set-soft/RemoteControl/electronics/mainboard/mainboard.step

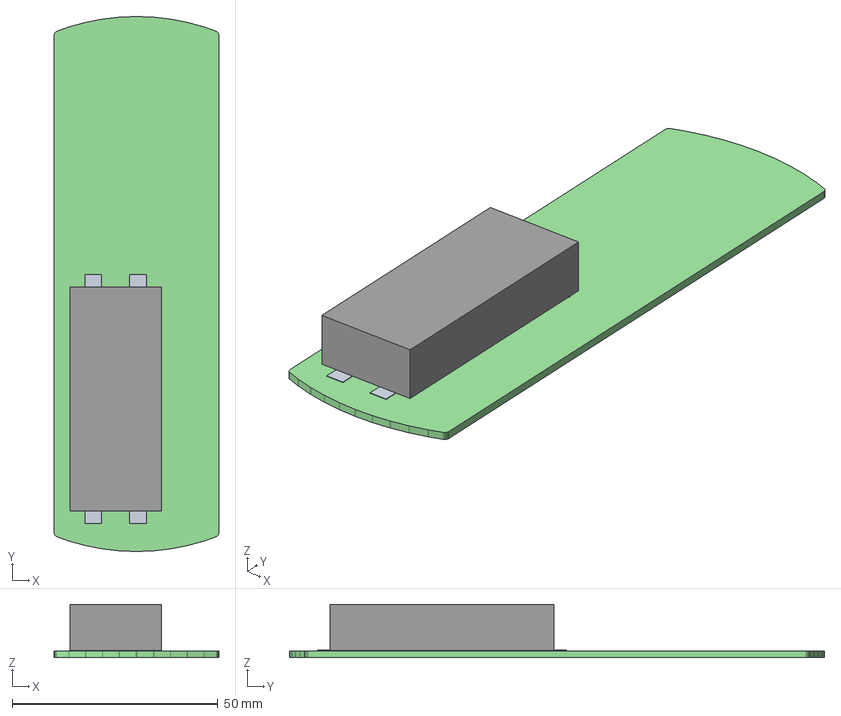
[picture p1: CAD file, 2022-05-20]
electronics/mainboard/mainboard.step
40.0 x 130.0 x 13.0 mm
mainboard PCB
