set-soft/RemoteControl/mechanics/mainboard.3mf

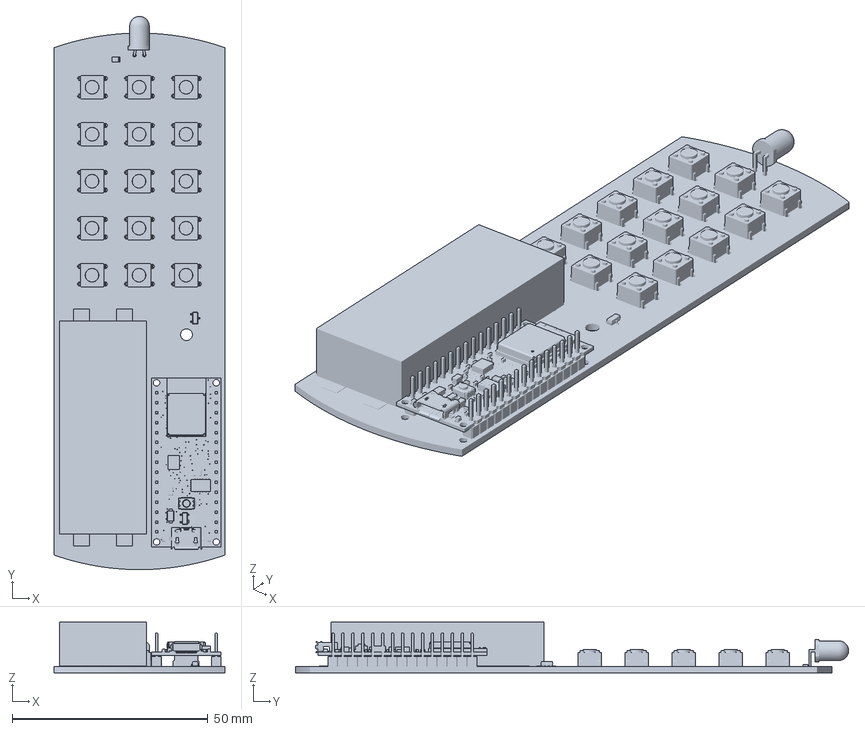
[picture p2: CAD file, 2022-06-04]
mechanics/mainboard.3mf
43.7 x 141.3 x 12.9 mm
