set-soft/RemoteControl/mechanics/mainboard_outline.dxf

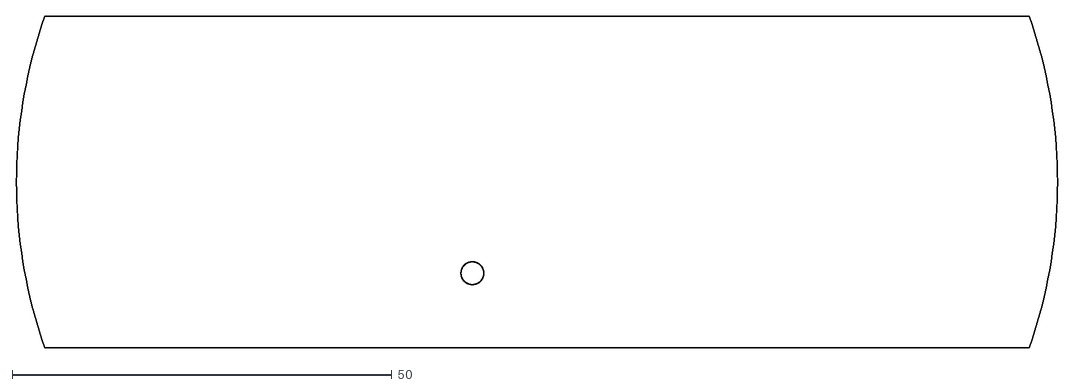
[picture p3: CAD file, 2022-06-04]
mechanics/mainboard_outline.dxf
137.0 x 43.7
