set-soft/RemoteControl/mechanics/printLayout.3mf

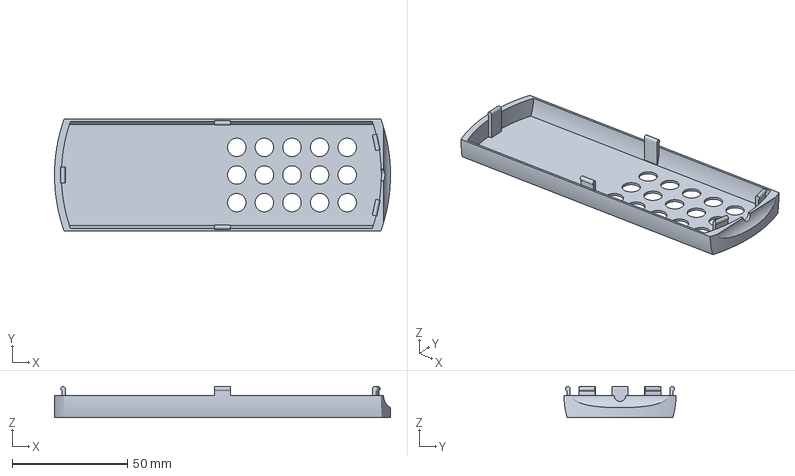
[picture p4: CAD file, 2022-06-06]
mechanics/printLayout.3mf
146.0 x 48.7 x 13.5 mm
