set-soft/RemoteControl/mechanics/buttons.3mf

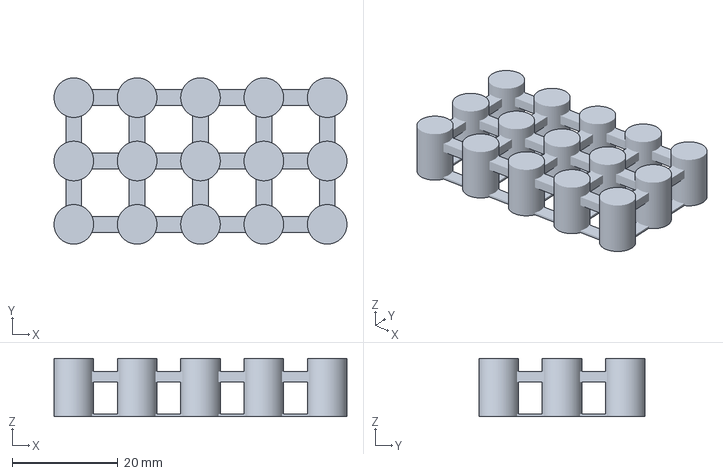
[picture p5: CAD file, 2022-06-06]
mechanics/buttons.3mf
55.5 x 31.5 x 11.0 mm
