set-soft/RemoteControl/mechanics/parameters.scad

case_wallThickness = 1;

case_length = 146;
case_width = case_length/3;
case_height = 19;

case_innerLength = case_length - 5 - 2*case_wallThickness;
case_innerWidth = case_width - 2*case_wallThickness;
case_innerHeight = case_height - 2*case_wallThickness;

pcb_thickness = 1.6;
pcb_bottomClearance = 2.5;
