set-soft/RemoteControl/mechanics/printLayout.scad

use <case.scad>

translate([0, 55, 0])
	rotate([180, 0, 0])
		case_upper();

case_lower();
