set-soft/RemoteControl/(list of files, cad)

Other CAD files:
electronics/mainboard/mainboard.stl
mechanics/buttons.stl
mechanics/printLayout.stl
