set-soft/RemoteControl/electronics/mainboard/mainboard.kicad_pcb

## KiCad design electronics/mainboard/mainboard.kicad_pcb (2022-06-10)

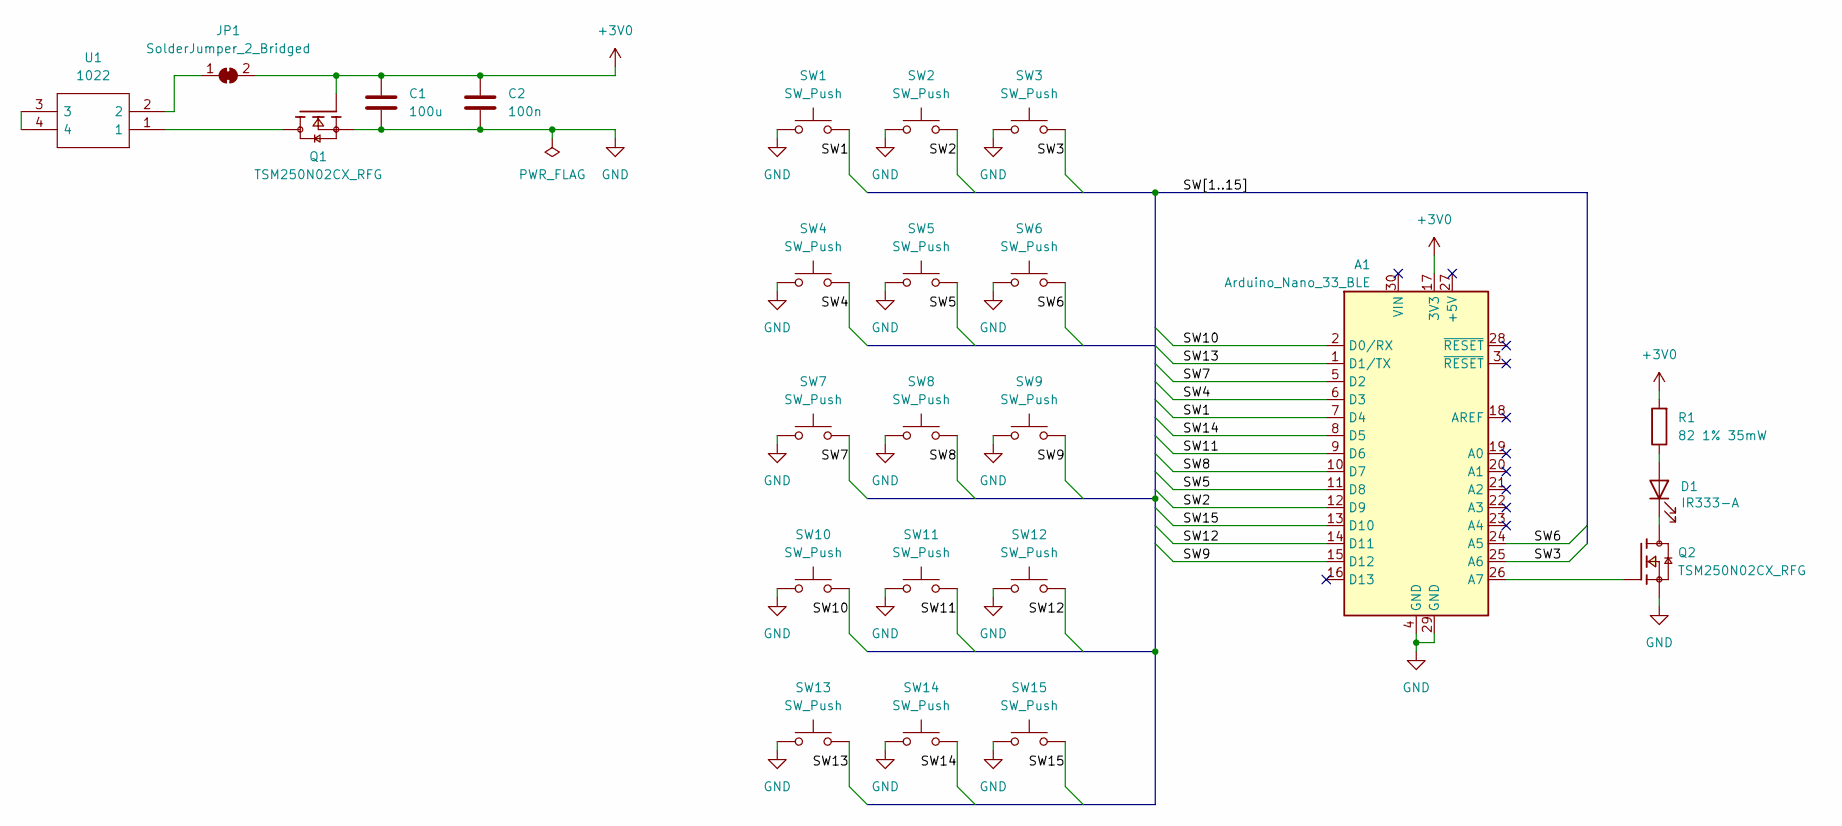
[picture p6: schematic mainboard.kicad_sch]

Parts:
A1: Arduino_Nano_33_BLE; Arduino_Nano_WithMountingHoles
C1: 100u; C_0805_2012Metric
C2: 100n; C_0805_2012Metric
D1: IR333-A; LED_D5.0mm_Horizontal_O1.27mm_Z3.0mm
JP1: SolderJumper_2_Bridged; SolderJumper-2_P1.3mm_Bridged_Pad1.0x1.5mm
Q1, Q2: TSM250N02CX_RFG; TRANS_TSM250N02CX_RFG; PARTREV A2007
R1: 82 1% 35mW; R_0805_2012Metric
SW1, SW2, SW3, SW4, SW5, SW6, SW7, SW8, SW9, SW10, SW11, SW12, SW13, SW14, SW15: SW_Push; SW_PUSH_6mm
U1: 1022; Mouser Part Number 534-1022

Connections:
+3V0: A1.17 (3V3), C1.1, C2.1, JP1.2 (B), Q1.1, R1.2
/SW1: A1.7 (D4), SW1.2
/SW2: A1.12 (D9), SW2.2
/SW3: A1.25 (A6), SW3.2
/SW4: A1.6 (D3), SW4.2
/SW5: A1.11 (D8), SW5.2
/SW6: A1.24 (A5), SW6.2
/SW7: A1.5 (D2), SW7.2
/SW8: A1.10 (D7), SW8.2
/SW9: A1.15 (D12), SW9.2
/SW10: A1.2 (D0/RX), SW10.2
/SW11: A1.9 (D6), SW11.2
/SW12: A1.14 (D11), SW12.2
/SW13: A1.1 (D1/TX), SW13.2
/SW14: A1.8 (D5), SW14.2
/SW15: A1.13 (D10), SW15.2
GND: A1.4 (GND), A1.29 (GND), C1.2, C2.2, Q1.2, Q2.2, SW1.1, SW2.1, SW3.1, SW4.1, SW5.1, SW6.1, SW7.1, SW8.1, SW9.1, SW10.1, SW11.1, SW12.1, SW13.1, SW14.1, SW15.1
unnamed: A1.26 (A7), Q2.1
unnamed: D1.1 (K), Q2.3
unnamed: D1.2 (A), R1.1
unnamed: JP1.1 (A), U1.2
unnamed: Q1.3, U1.1
unnamed: U1.3, U1.4

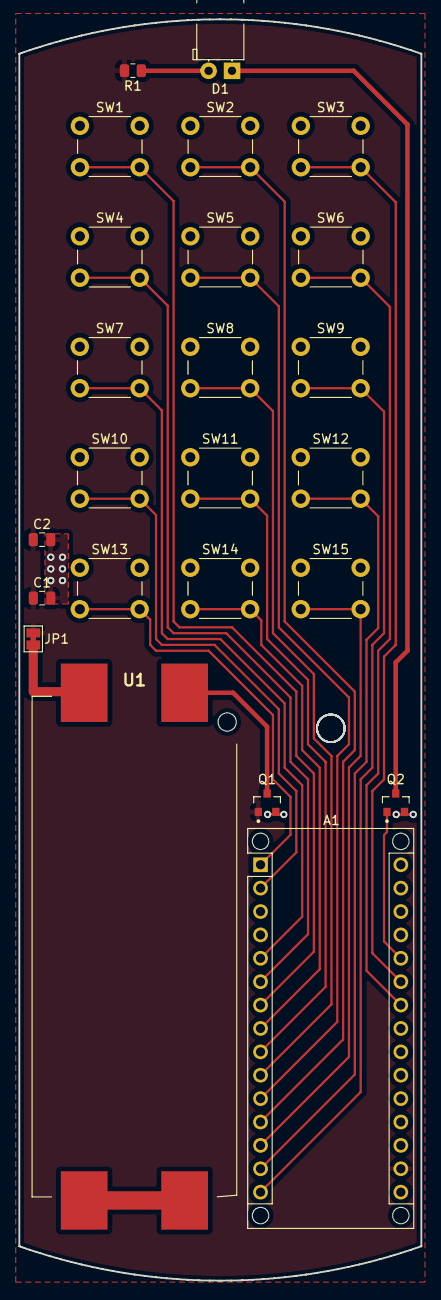
[picture p7: board mainboard.kicad_pcb from above]

Board: 2 copper layers, 43.7 x 137.0 mm, 24 parts (0 on the bottom side), 23 nets.
