set-soft/RemoteControl/software/firmware/include/turnTable.h

#pragma once

namespace turnTable{
	enum class Command{
		TurnClockWise,
		TurnCounterClockWise,
	};

	extern void (*init)();
	extern void (*tick)();
	extern void (*sendCommand)(Command command);
	extern bool (*isConnected)();
	extern void (*disconnect)();
}
