set-soft/RemoteControl/software/firmware/include/FINLUX__32FLE845_Eco__IrRemote.h

#pragma once

#include "Philips_RC5_IrRemoteProtocol.h"

namespace FINLUX__32FLE845_Eco{
	enum class Command{
		ToggleStandby,
	};

	typedef void (*InfraRed_on)();
	typedef void (*InfraRed_off)();
	typedef void (*WaitMicroseconds)(unsigned int microSeconds);

	extern void (*init)(const InfraRed_on infraRed_on, const InfraRed_off infraRed_off, const WaitMicroseconds waitUs);
	extern void (*send)(Command command);
}
