set-soft/RemoteControl/(commit log)

2021-11-01 simple case
    [case.scad]
2021-12-16 add buttons to control led
2021-12-19 corrected mock parameter names
    [Arduino.cpp]
2021-12-19 add unit tests for buttons
2022-03-24 mock interrupts on/off functions
2022-03-24 add two more buttons
2022-04-02 remove interferences and make usable
    [buttons.cpp, buttons.h, main.cpp]
2022-04-10 remove classes
    Classes have been removed as this would have made functors necessary which rises problems with CPPUTEST.
    [FINLUX__32FLE845_Eco__IrRemote.h, MELECTRONIC__MC_MI_1212__IrRemote.cpp, MELECTRONIC__MC_MI_1212__IrRemote.h, irRemoteHandler.cpp]
2022-04-11 unit test buttons
2022-05-14 integrate low power
2022-05-18 another idea for the case
    [case.scad]
2022-05-18 change material to petg
    [case.3mf]
2022-05-19 add mainboard outline
    [case.scad, case_parameters.scad, mainboard_outline.scad]
2022-05-20 create electronics project
    [mainboard.kicad_pcb, mainboard.kicad_sch, mainboard.step, mainboard.stl]
2022-05-20 integrate mainboard pcb
    [case.scad, mainboard_outline.dxf, mainboard_outline.scad]
2022-05-20 add arduino nano to pcb
    [case_parameters.scad, mainboard.kicad_pcb, mainboard.kicad_sch, mainboard_outline.dxf]
2022-05-20 add buttons and ir-led
    [mainboard.kicad_pcb, mainboard.kicad_sch]
2022-05-20 add schematic connections
    [mainboard.kicad_pcb, mainboard.kicad_sch]
2022-05-21 add polarity protection
    [mainboard.kicad_pcb, mainboard.kicad_sch]
2022-05-21 add hole for id-led
    [assembly.scad, case.scad]
2022-05-21 add hole for ir led
    [assembly.scad, case.scad, case_parameters.scad, mainboard_outline.dxf, mainboard_outline.scad, parameters.scad]
2022-05-21 align buttons and ir-led
    [assembly.scad, mainboard.kicad_pcb]
2022-05-23 add pin headers to 3d model of arduino
    [mainboard.kicad_pcb]
2022-05-23 add pcb bottom support
    [assembly.scad, case.scad]
2022-05-23 add pcb positioning pole
    [case.scad, mainboard.kicad_pcb, mainboard_outline.dxf, mainboard_outline.scad]
2022-05-23 add button holes
    [assembly.scad, case.scad]
2022-05-26 add things for case mounting
    [assembly.scad, case.3mf, case.scad, printLayout.3mf, printLayout.scad, printLayout.stl, printLayout_flex.3mf, printLayout_flex.scad]
2022-05-28 optimize case - different alignment - printing optimizations
    [assembly.scad, case.scad, parameters.scad, printLayout.3mf, printLayout.scad]
2022-05-28 add support for LED
    [printLayout.3mf]
2022-06-04 modify closing mechanism and printing improvements - remove rounding (minkowski) for better printability - add closing mechanisms with levers => remove backring as no longer needed => remove position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
    [assembly.scad, case.scad, mainboard.kicad_pcb, mainboard_outline.dxf, parameters.scad, printLayout.3mf, printLayout.scad]
2022-06-05 clean up libraries and add more parts to desing - clean up libraries folder structure - no longer ignore important library table files - ignore auto save files - add fet for polarity protection - add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
    [mainboard.kicad_pcb, mainboard.kicad_sch]
2022-06-05 driver for ir-led and minor optimizations
    [mainboard.kicad_pcb, mainboard.kicad_sch]
2022-06-06 add buttons
    [assembly.scad, buttons.3mf, buttons.scad, buttons.stl, case.scad, printLayout.3mf, printLayout.stl, printLayout_flex.3mf]
2022-06-06 add variable layer height
    [printLayout.3mf]
2022-06-06 route pcb
    [mainboard.kicad_pcb, mainboard.kicad_sch]
2022-06-07 resolve drc errors and warnings
    [mainboard.kicad_pcb]
2022-06-07 clarify designator of arduino
    [mainboard.kicad_pcb, mainboard.kicad_sch]
2022-06-08 optimize position of designator JP1 und U1
    [mainboard.kicad_pcb]
2022-06-10 resolve ERC warnings and errors
    [mainboard.kicad_sch]
2022-06-10 resolve drc warning by modifying footprint and removing exclusions
    [mainboard.kicad_pcb]
